Biacco42/Ergo42/ergo42_case/ergo42-case-3_0_0_elecrow.PNG

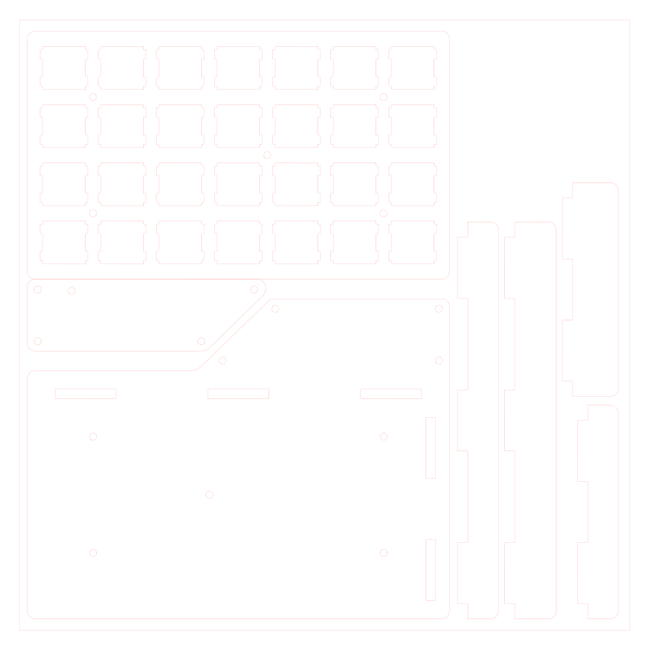
ergo42_case/ergo42-case-3_0_0_elecrow.PNG
