Biacco42/Ergo42/(threads)

Thread 2 (2017-11-21):

Round PCB corner

Biacco42, 2017-11-21:
It hurts

Biacco42, 2018-02-19:
fixed by 2.0.0

Closed 2018-02-19.
