Biacco42/Ergo42/(commit log)

2017-10-19 Add libraries
    [ergo42.kicad_pcb, ergo42.sch]
2017-10-28 Implement TRRS footprint
2017-10-28 Add footprint document
2017-10-31 Add case design
2017-10-31 Move case design file
2017-11-01 Implement circuit schematic
    [ergo42.sch]
2017-11-01 Mod 5PIN pin category
2017-11-01 Build net list
    [ergo42.sch]
2017-11-05 Place parts on pcb
    [ergo42.kicad_pcb]
2017-11-11 Update library in pcb and some diord position
    [ergo42.kicad_pcb]
2017-11-11 Implement key matrix wire
    [ergo42.kicad_pcb]
2017-11-11 Fill GND/Vcc
    [ergo42.kicad_pcb]
2017-11-11 Correct error
    [ergo42.kicad_pcb]
2017-11-11 Output gerber
    [ergo42-B.Cu.gbl, ergo42-B.Mask.gbs, ergo42-B.SilkS.gbo, ergo42-Edge.Cuts.gm1, ergo42-F.Cu.gtl, ergo42-F.Mask.gts, ergo42-F.SilkS.gto, ergo42-NPTH.drl]
2017-11-11 Update case design
2017-11-12 Add signature to pcb
    [ergo42.kicad_pcb]
2017-11-12 Update gerber files
    [ergo42-B.Cu.gbl, ergo42-B.Mask.gbs, ergo42-B.SilkS.gbo, ergo42-Edge.Cuts.gm1, ergo42-F.Cu.gtl, ergo42-F.Mask.gts, ergo42-F.SilkS.gto, ergo42-NPTH.drl]
2017-11-19 Fix case hole misplace
2017-12-08 Fix Kailh low / Cherry MX cross footprint
2017-12-09 Layout parts
    [ergo42.kicad_pcb, ergo42.sch]
2017-12-10 Add cutting edge
    [ergo42.kicad_pcb, ergo42.sch]
2017-12-10 Add tracks
    [ergo42.kicad_pcb, ergo42.sch]
2017-12-10 Add Logo silk
    [ergo42.kicad_pcb]
2017-12-21 Update garber
    [ergo42-B.Cu.gbl, ergo42-B.Mask.gbs, ergo42-B.SilkS.gbo, ergo42-Edge.Cuts.gm1, ergo42-F.Cu.gtl, ergo42-F.Mask.gts, ergo42-F.SilkS.gto, ergo42.drl]
2018-01-14 Update diode SMD pad
2018-01-14 Fix PCB layout margin
    [ergo42.kicad_pcb]
2018-01-14 Update diode footprint in PCB
    [ergo42.kicad_pcb]
2018-01-14 Update gerber
    [ergo42-B.Cu.gbl, ergo42-B.Mask.gbs, ergo42-B.SilkS.gbo, ergo42-Edge.Cuts.gm1, ergo42-F.Cu.gtl, ergo42-F.Mask.gts, ergo42-F.SilkS.gto, ergo42.drl]
2018-01-15 Add reset button hole to upper case
2018-01-28 Mod plate edge
    [ergo42.kicad_pcb]
2018-02-19 Add case design file for elecrow
2018-04-24 Add Cherry MX with < 3mm thickness plate warning.
2018-07-09 Update libraries
    [ergo42.sch]
2018-07-09 Apply new Pro Micro Reversible library to PCB
    [ergo42.kicad_pcb]
2018-07-09 Add Ergo42 logo
    [ergo42.kicad_pcb]
2018-09-16 Fix TRRS jack NPTH size
    [ergo42-B.Cu.gbl, ergo42-B.Mask.gbs, ergo42-B.SilkS.gbo, ergo42-Edge.Cuts.gm1, ergo42-F.Cu.gtl, ergo42-F.Mask.gts, ergo42-F.SilkS.gto, ergo42.drl]
2018-12-29 Release TRRS Jack Fix
    [ergo42-B.Cu.gbr, ergo42-B.Mask.gbr, ergo42-B.Mask.gbs, ergo42-B.SilkS.gbr, ergo42-Edge.Cuts.gbr, ergo42-F.Cu.gbr, ergo42-F.Mask.gbr, ergo42-F.Mask.gts]
